fcefyn-testbed/fcefyn_testbed_utils/docs/diseno/rack-diseno-3d.md

---
title: Rack físico
---

# Rack físico

Vista general del **rack en torre** del lab: cajoneras, caja de control, enlace a esquemáticos eléctricos en [arduino-relay](../configuracion/arduino-relay.md) y piezas impresas para conductos y soportes. Fuentes CAD: carpeta **`3d_parts/`** en la raíz del repo (OpenSCAD homónimo del STL cuando aplica).

## Fotos del rack

<div class="rack-gallery" data-rack-gallery tabindex="0">
  <div class="rack-gallery__viewport">
    <figure class="rack-gallery__slide" data-caption="Vista general del rack en torre: cajoneras, cableado y equipos por cajón.">
      Rack en torre con cajoneras plásticas y cableado
    </figure>
    <figure class="rack-gallery__slide" data-caption="Montaje inicial en mesa: routers, hub USB, relés y cableado antes de integrar al rack.">
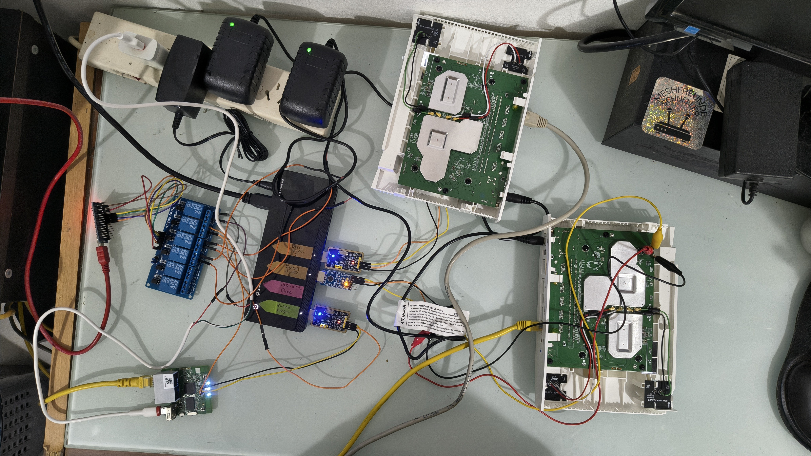
[picture p1: docs/img/rack/starting_point.jpg]
Banco de pruebas en mesa con routers y relés
      
    </figure>
    <figure class="rack-gallery__slide" data-caption="Interior de un cajón: hub USB, módulo de relés y distribución de cables.">
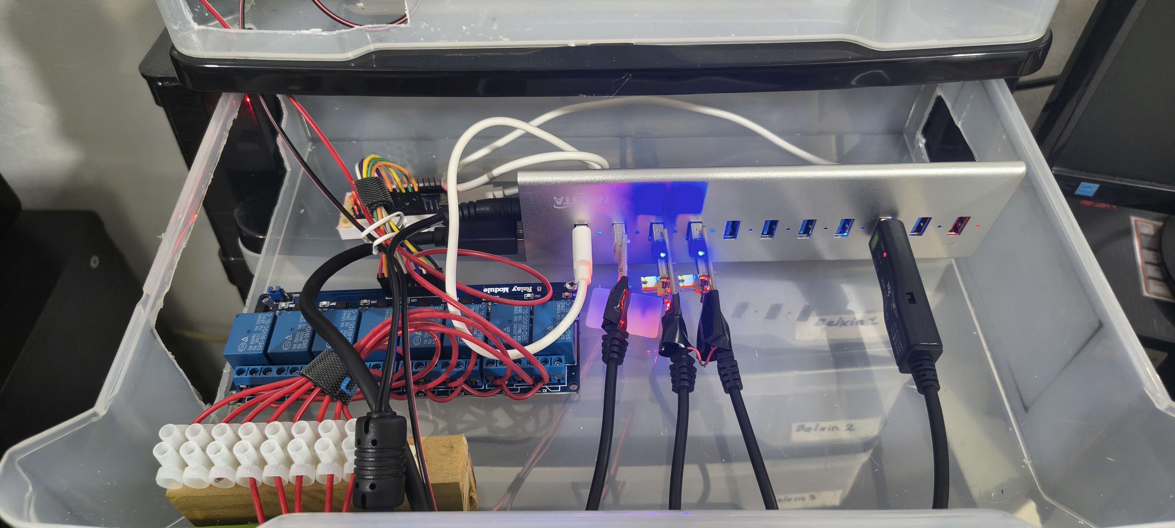
[picture p2: docs/img/rack/rack_2nd_level.jpg]
Cajón del rack con hub USB y relés
      
    </figure>
    <figure class="rack-gallery__slide" data-caption="Cajones superiores abiertos: fuente, hub y cableado entre niveles.">
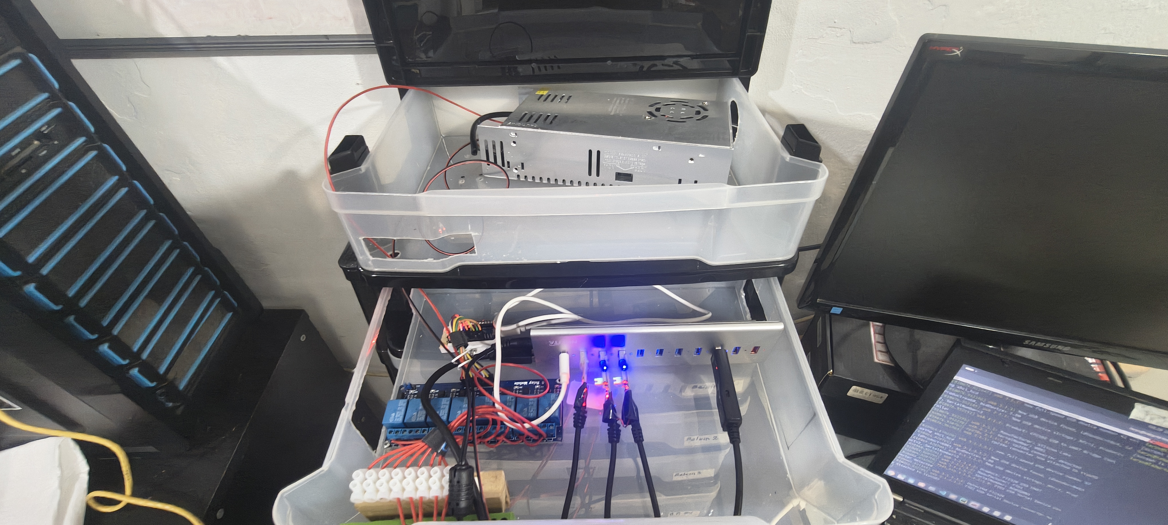
[picture p3: docs/img/rack/rack_1st_2nd_level.jpg]
Dos niveles del rack abiertos con fuente y cableado
      
    </figure>
    <div class="rack-gallery__overlay">
      <span class="rack-gallery__counter" data-rack-counter aria-live="polite"></span>
      <button type="button" class="rack-gallery__btn" data-rack-prev aria-label="Imagen anterior">&#8249;</button>
      <button type="button" class="rack-gallery__btn" data-rack-next aria-label="Imagen siguiente">&#8250;</button>
    </div>
  </div>
  
</div>

## Caja de control (módulo de relés)

Caja aparte del rack: relés/SSR, **UTP** (señal) y **230 V** hacia cooler y fuente. Detalle eléctrico: [arduino-relay](../configuracion/arduino-relay.md).

<div class="rack-gallery" data-rack-gallery tabindex="0">
  <div class="rack-gallery__viewport">
    <figure class="rack-gallery__slide" data-caption="Caja externa del módulo de relés (caja de control).">
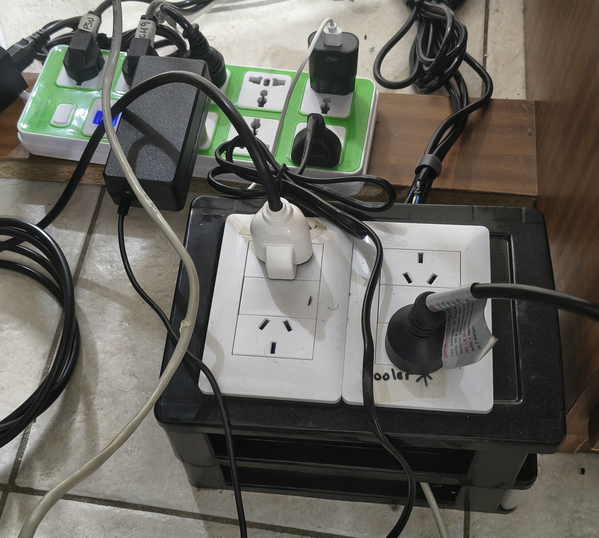
[picture p4: docs/img/rack/reles_box_1.jpg]
Caja de módulo de relés vista exterior
      
    </figure>
    <figure class="rack-gallery__slide" data-caption="Interior: Arduino, relés/SSR y cableado a bornes y UTP.">
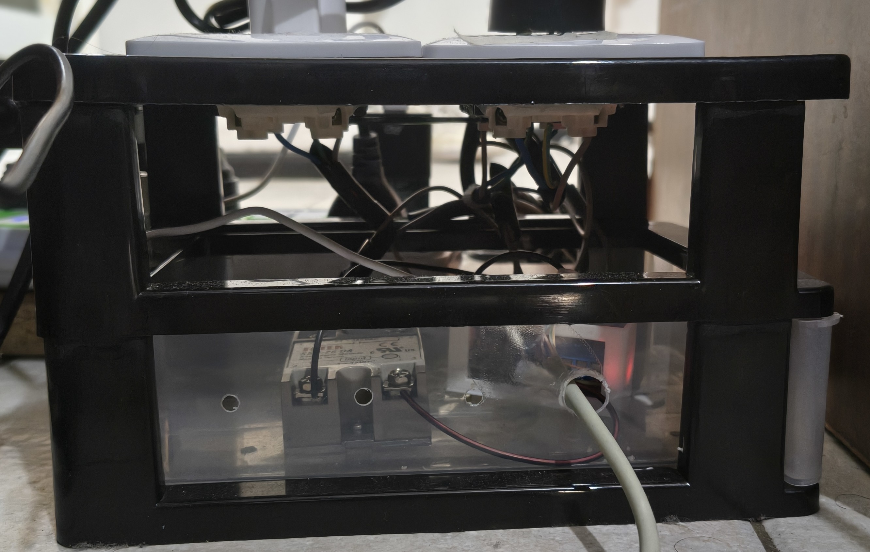
[picture p5: docs/img/rack/reles_box_inside.jpg]
Interior de la caja de relés
      
    </figure>
    <div class="rack-gallery__overlay">
      <span class="rack-gallery__counter" data-rack-counter aria-live="polite"></span>
      <button type="button" class="rack-gallery__btn" data-rack-prev aria-label="Imagen anterior">&#8249;</button>
      <button type="button" class="rack-gallery__btn" data-rack-next aria-label="Imagen siguiente">&#8250;</button>
    </div>
  </div>
  
</div>

## Conexiones y cableado eléctrico {: #conexiones-y-cableado-electrico }

Los esquemáticos de referencia están en [arduino-relay - Esquemas eléctricos](../configuracion/arduino-relay.md#esquemas-electricos-referencia) junto con tablas de pines y comandos serial.

## Consideraciones térmicas y ventilación {: #consideraciones-termicas }

Con el apilado vertical, el aire caliente de los niveles inferiores **asciende** y tiende a estancarse arriba, con riesgo de sobrecalentamiento en los equipos superiores. La mitigación es un **ventilador inferior** (120 mm, 220 V) que empuja aire **frío de abajo hacia arriba** y **conductos impresos** que encaminan el flujo hacia los cajones. Ficha del ventilador: [Catálogo - Bosser 120 mm](../configuracion/catalogo-hardware.md#ventilador-bosser-120-mm-rack).

## Piezas impresas en 3D

Renders y fotos de las piezas usadas en conductos, bases y accesorios. Modelos orientados a imprimir **sin soportes** cuando corresponde (referencia: Creality Ender 3 Pro).

| Cantidad | Archivo STL | Uso |
|---|---|-----|
| 1 | `curved_intake_duct.stl` | Conducto curvo: ventilador 120 mm → chimenea |
| 4 | `airflow_chimney_duct_3levels.stl` | Segmentos verticales con rejillas (3 niveles c/u) |
| 1 | `airflow_chimney_duct_2levels.stl` | Segmento con 2 niveles |
| 1 | `chimney_duct_cover.stl` | Tapa superior de la chimenea |
| 3 | `belkin_rt3200_base.stl` | Base compacta Belkin RT3200 |
| 1 | `CE3PRO_librerouter_rack.stl` | Carcasa abierta LibreRouter (base ventilada, standoffs) |
| 1 | `NanoHolderA.stl` | Soporte Arduino Nano |
| 1 | (aux.) `drawer_stop` | Guía / tope de cajón (asset visual; nombre de archivo según `3d_parts/`) |
| (var.) | `logo fcefyn.stl`, `logo unc.stl` | Logos decorativos |

<div class="rack-gallery rack-gallery--schematics" data-rack-gallery tabindex="0">
  <div class="rack-gallery__viewport">
    <figure class="rack-gallery__slide" data-caption="Conducto de admisión curvado (render OpenSCAD / referencia).">
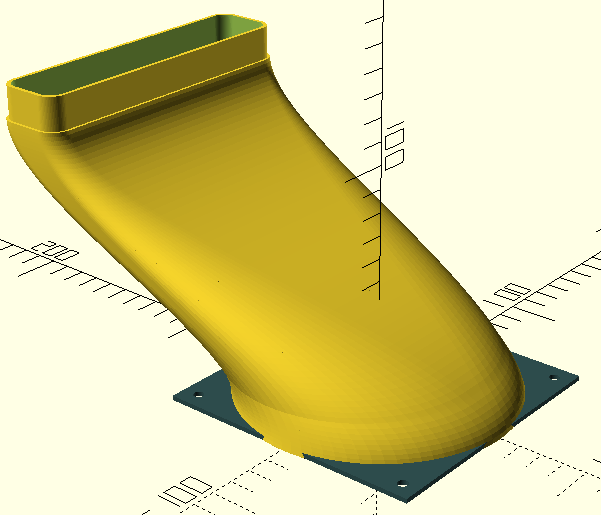
[picture p6: docs/img/rack/curved_intake_duct.png]
Render conducto admisión curvado
      
    </figure>
    <figure class="rack-gallery__slide" data-caption="Módulo chimenea 3 niveles (rejillas orientadas a los routers).">
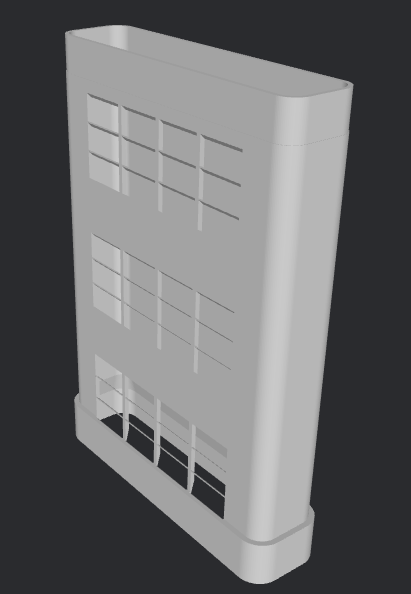
[picture p7: docs/img/rack/airflow_chimney_duct_3levels.png]
Render chimenea tres niveles
      
    </figure>
    <figure class="rack-gallery__slide" data-caption="Módulo chimenea 2 niveles.">
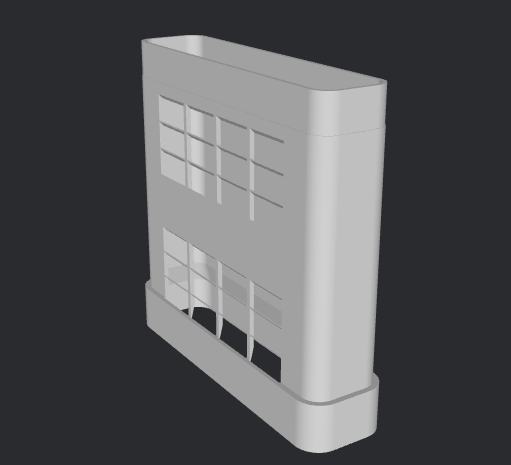
[picture p8: docs/img/rack/airflow_chimney_duct_2levels.png]
Render chimenea dos niveles
      
    </figure>
    <figure class="rack-gallery__slide" data-caption="Tapa superior de chimenea.">
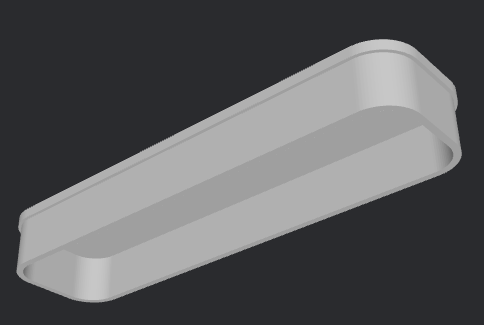
[picture p9: docs/img/rack/chimney_duct_cover.png]
Render tapa chimenea
      
    </figure>
    <figure class="rack-gallery__slide" data-caption="Ventilador 120 mm con conducto curvo montado (foto).">
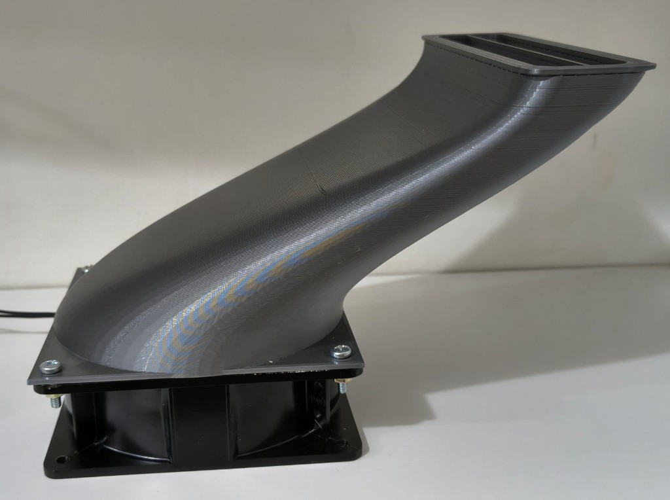
[picture p10: docs/img/rack/cooler_with_duct.jpeg]
Ventilador con conducto curvo montado
      
    </figure>
    <figure class="rack-gallery__slide" data-caption="Base impresa Belkin RT3200 en el rack.">
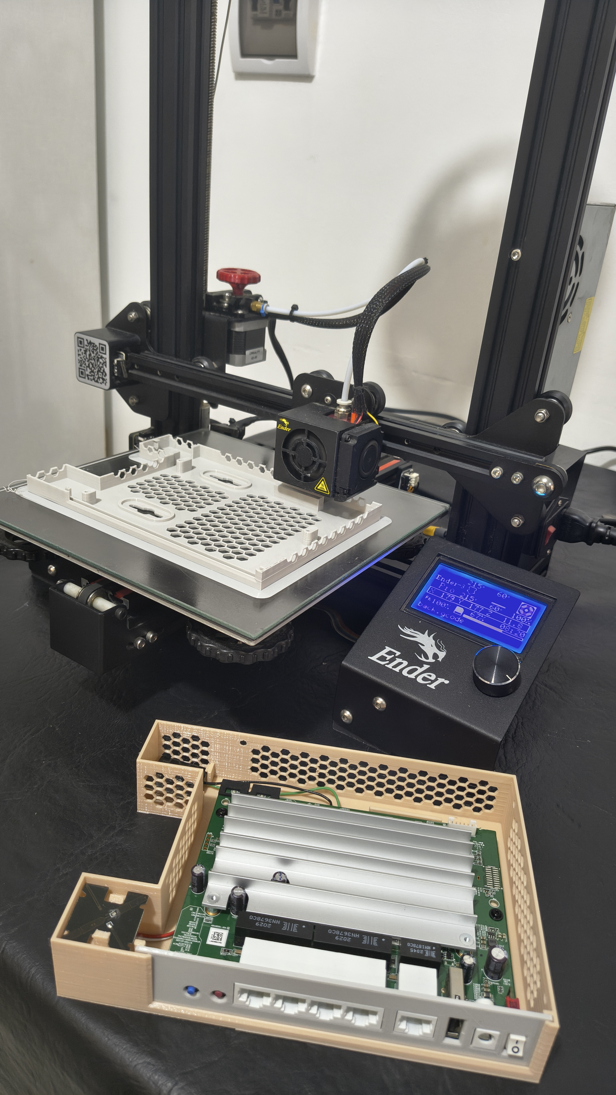
[picture p11: docs/img/rack/belkin_case_adapted.jpg]
Base Belkin adaptada en rack
      
    </figure>
    <figure class="rack-gallery__slide" data-caption="Carcasa abierta LibreRouter.">
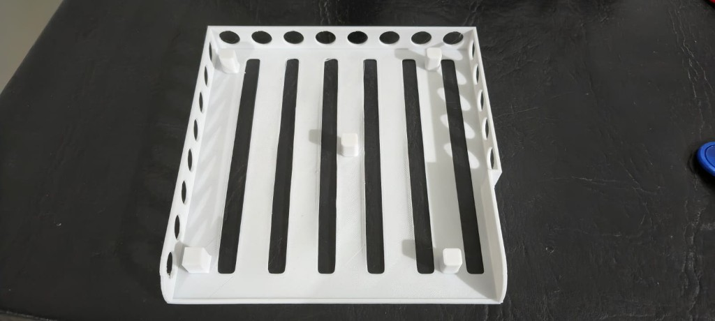
[picture p12: docs/img/rack/librerouter-opencase.jpeg]
Carcasa abierta LibreRouter
      
    </figure>
    <figure class="rack-gallery__slide" data-caption="Soporte Arduino Nano (NanoHolder).">
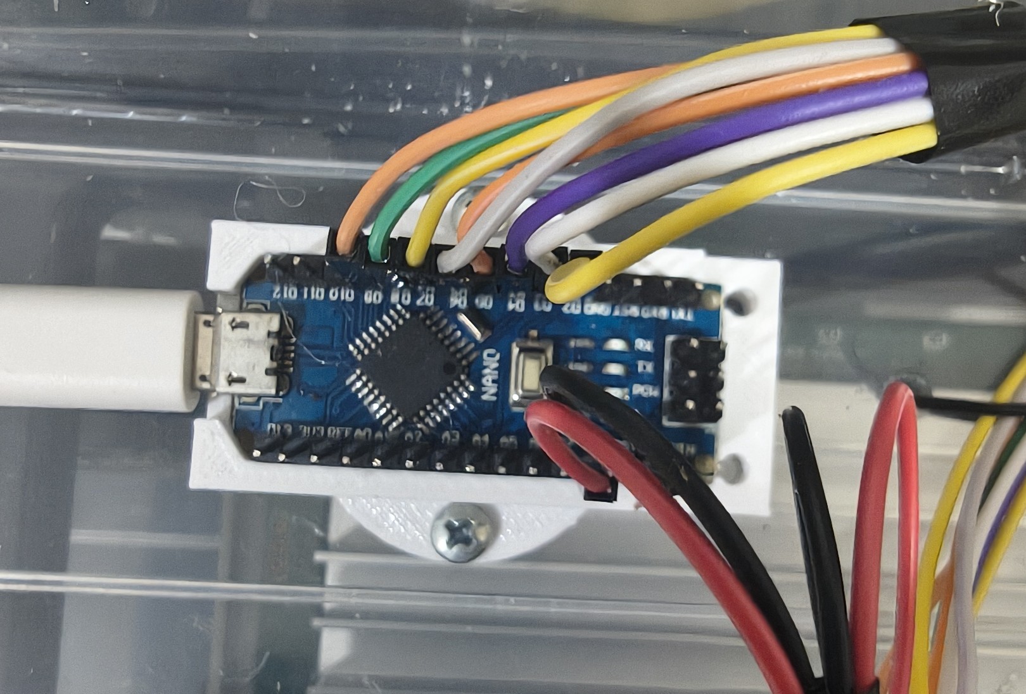
[picture p13: docs/img/rack/NanoHolder.jpg]
Soporte Nano impreso
      
    </figure>
    <figure class="rack-gallery__slide" data-caption="Logos FCEFyN y UNC.">
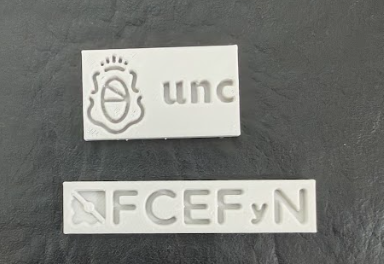
[picture p14: docs/img/rack/logos.png]
Logos FCEFyN y UNC
      
    </figure>
    <div class="rack-gallery__overlay">
      <span class="rack-gallery__counter" data-rack-counter aria-live="polite"></span>
      <button type="button" class="rack-gallery__btn" data-rack-prev aria-label="Imagen anterior">&#8249;</button>
      <button type="button" class="rack-gallery__btn" data-rack-next aria-label="Imagen siguiente">&#8250;</button>
    </div>
  </div>
  
</div>

La base Belkin deriva de [RT3200/E8450 Wall Mount Case](https://www.thingiverse.com/thing:5864938) (TuxInvader): solo la base, parte superior abierta para ventilación.
