fcefyn-testbed/fcefyn_testbed_utils/docs/img/hardware/cooler_bosser.png

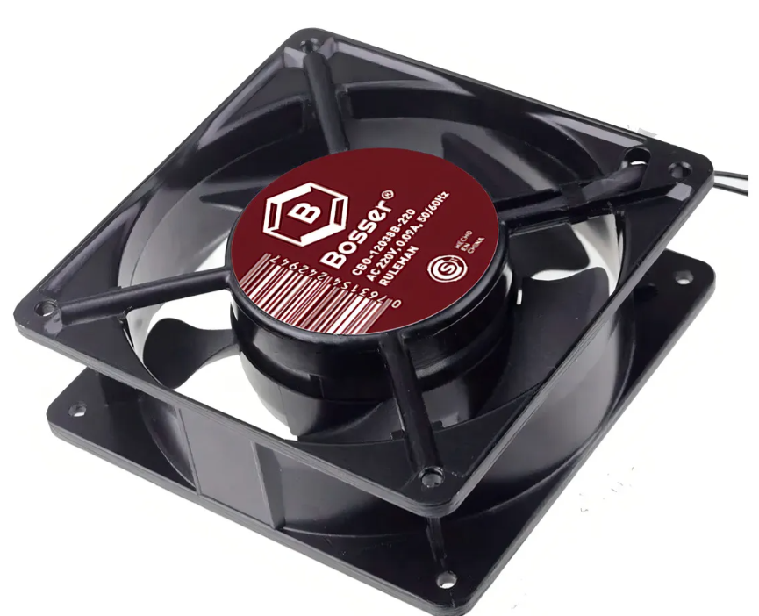
docs/img/hardware/cooler_bosser.png
