fcefyn-testbed/fcefyn_testbed_utils/docs/img/rack/hub_shelf.jpg

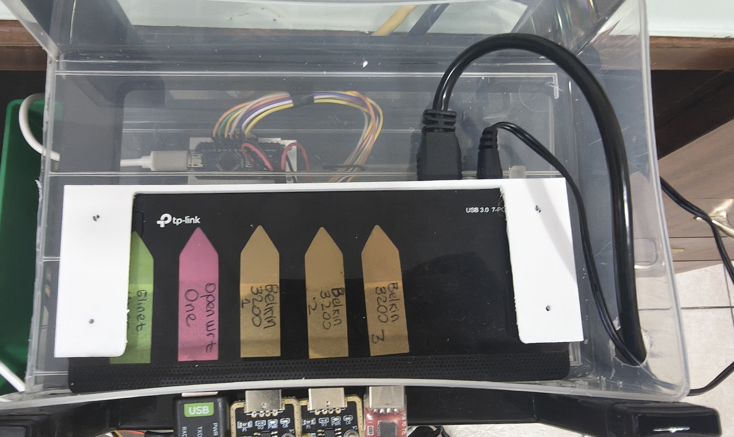
docs/img/rack/hub_shelf.jpg
