fcefyn-testbed/fcefyn_testbed_utils/docs/img/rack/rack.jpg

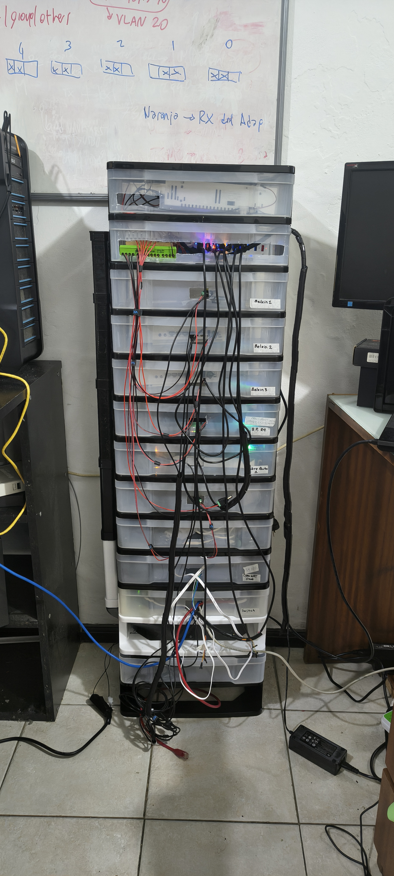
docs/img/rack/rack.jpg
