fcefyn-testbed/fcefyn_testbed_utils/docs/img/rack/schematics/rack-ac-infra.png

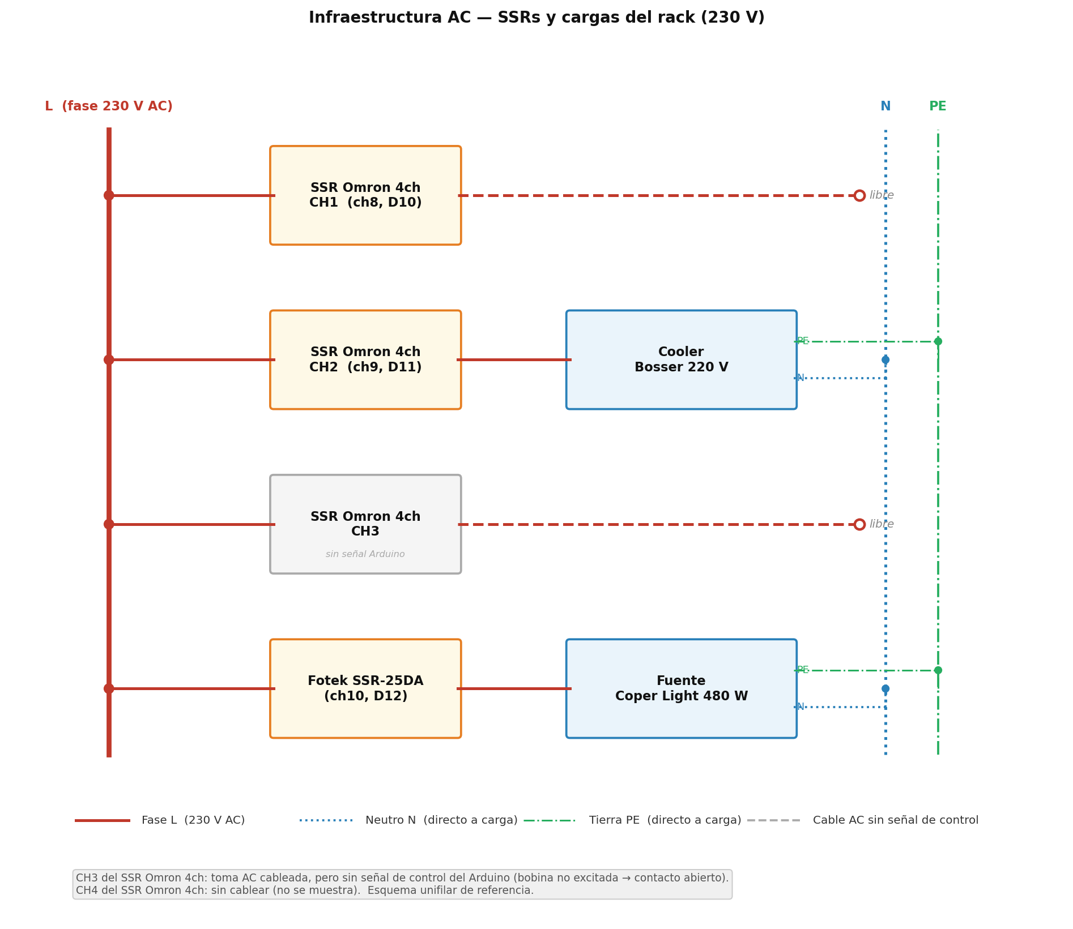
docs/img/rack/schematics/rack-ac-infra.png
