fcefyn-testbed/fcefyn_testbed_utils/docs/img/rack/schematics/rack-dut-relays.png

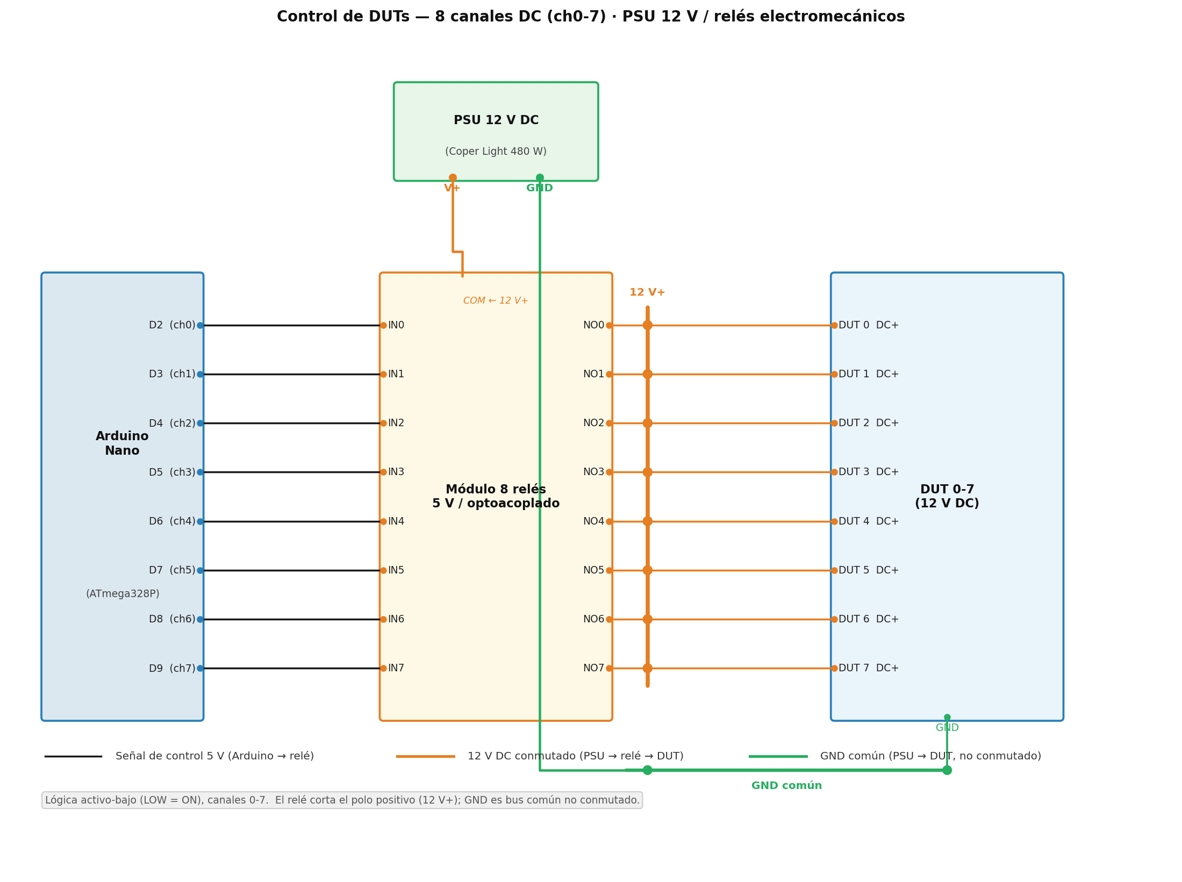
docs/img/rack/schematics/rack-dut-relays.png
