fcefyn-testbed/fcefyn_testbed_utils/docs/img/rack/schematics/rack-signal-utp.png

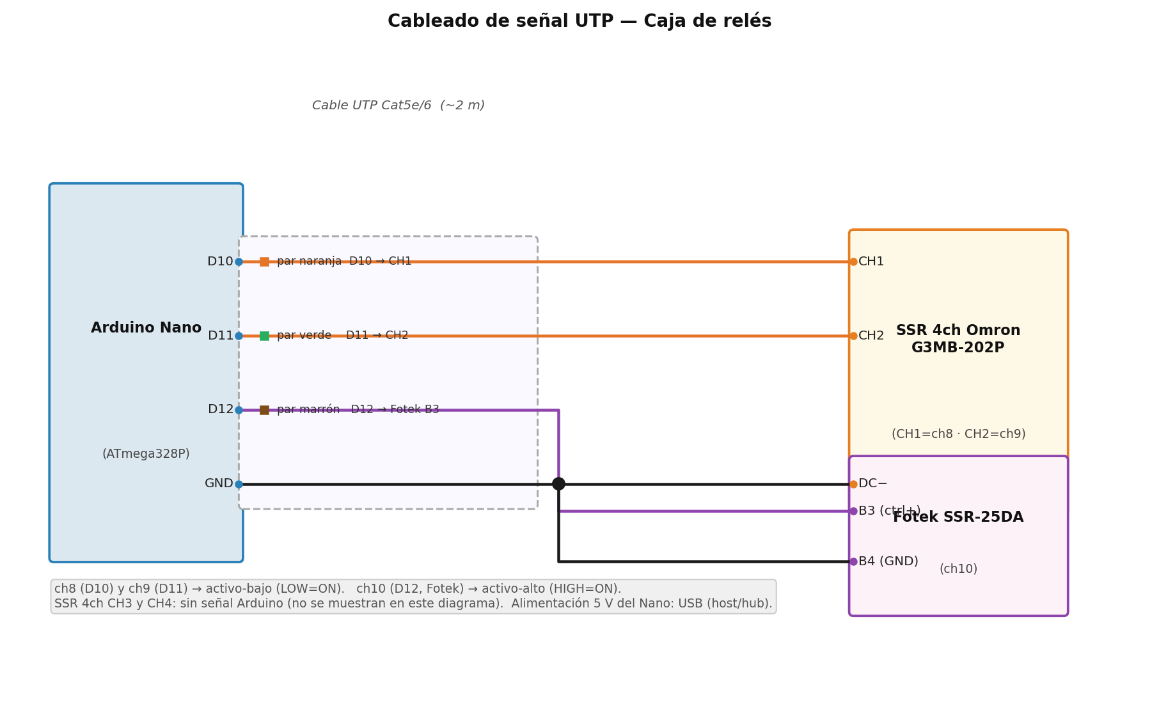
docs/img/rack/schematics/rack-signal-utp.png
