fcefyn-testbed/fcefyn_testbed_utils/(list of files, cad)

Other CAD files:
3d_parts/CE3PRO_librerouter_rack.stl
