fcefyn-testbed/fcefyn_testbed_utils/docs/operar/build-firmware-manual.md

# Manual firmware build (OpenWrt / LibreMesh)

Guide to build images for the lab (`LG_IMAGE`, TFTP).

**Canonical libremesh-tests docs** (suite behaviour, CI image catalog): [LibreMesh testing approach](https://github.com/francoriba/libremesh-tests/blob/main/docs/libremesh-testing-approach.md), [CI firmware catalog](https://github.com/francoriba/libremesh-tests/blob/main/docs/ci-firmware-catalog.md).

---

## Build config per DUT

| DUT | Arch | Subtarget | Profile |
|-----|---|---|---|
| Belkin RT3200 | Mediatek (ARM) | mt7622 | linksys_e8450-ubi |
| Banana Pi R4 | Mediatek (ARM) | filogic | bananapi_bpi-r4 |
| OpenWRT One | Mediatek (ARM) | filogic | openwrt_one |
| LibreRouter 1 | ath79 (MIPS 24Kc) | generic | librerouter_librerouter-v1 |
| Gateway TL-WDR3500 | ath79 (MIPS 74Kc) | generic | tplink_tl-wdr3500-v1 |
| **QEMU x86-64** | x86 | x86_64 | generic |
| **QEMU Malta BE** | malta | be | generic |
| **QEMU armsr-armv8** | armsr | armv8 | generic |

**Usage:** `make menuconfig` → Target System → (Arch) → Subtarget → (Subtarget) → Target Profile → (Profile).

### LibreMesh (lime-packages)

**1. Clone OpenWrt and enter build root**

```bash
git clone -b v23.05.5 --single-branch https://git.openwrt.org/openwrt/openwrt.git
cd openwrt
```

**2. Feeds - OpenWrt default + LibreMesh**

```bash
cp feeds.conf.default feeds.conf
cat << 'EOF' >> feeds.conf

src-git libremesh https://github.com/libremesh/lime-packages.git;v2024.1
src-git profiles https://github.com/libremesh/network-profiles.git
EOF
```

`v2024.1` = LibreMesh 2024.1 (compatible with OpenWrt 23.05.5). Without suffix, `master` is used, which needs OpenWrt 24.10.

**3. Update and install packages**

```bash
scripts/feeds update -a
scripts/feeds install -a
```

**4. `make menuconfig` - Deselect**

| Location | Action |
|---|---|
| Image configuration → Separate feed repositories → Enable feed **libremesh** | Deselect |
| Image configuration → Separate feed repositories → Enable feed **profiles** | Deselect |
| Base system → **dnsmasq** | Deselect |
| Network → **odhcpd-ipv6only** | Deselect |

**5. `make menuconfig` - Select LibreMesh**

| Location |
|----------|
| LibreMesh → **babeld-auto-gw-mode** |
| LibreMesh → Offline Documentation → **lime-docs-minimal** |
| LibreMesh → **lime-app** |
| LibreMesh → **lime-hwd-openwrt-wan** |
| LibreMesh → **lime-proto-anygw** |
| LibreMesh → **lime-proto-babeld** |
| LibreMesh → **lime-proto-batadv** |
| LibreMesh → **shared-state** → shared-state-babeld_hosts |
| LibreMesh → **shared-state** → shared-state-bat_hosts |
| LibreMesh → **shared-state** → shared-state-nodes_and_links |

**5.1 Virtual targets with vwifi (optional)**

Only for mesh tests in QEMU (x86-64, Malta, armsr-armv8) using virtual WiFi:

| Step | Action |
|---|---|
| Feeds | Add to `feeds.conf`: `src-git vwifi https://github.com/javierbrk/vwifi_cli_package` |
| Update | `scripts/feeds update vwifi && scripts/feeds install -a` |
| Menuconfig | Network → **vwifi** |
| wpad | Include **wpad-basic-mbedtls** in the image (without it batman does not see interfaces on vwifi) |

**6. Build**

```bash
make -j$(nproc)
```

Binaries under `bin/targets/.../.../`.  
Source: [libremesh.org/development](https://libremesh.org/development.html)
