fcefyn-testbed/fcefyn_testbed_utils/scripts/switch_state.py

#!/usr/bin/env python3
"""
Switch state tracking - Persist last applied VLAN configuration for differential updates.

Written by pool-manager.py (hybrid mode) and switch_vlan_preset.py (isolated/mesh presets).
Used by pool-manager to avoid redundant switch commands when re-applying the same hybrid config.

State file: ~/.config/labgrid-switch-state.yaml
"""

import logging
import os
from pathlib import Path

try:
    import yaml
except ImportError:
    yaml = None

logger = logging.getLogger(__name__)

STATE_FILE = Path(os.path.expanduser("~/.config/labgrid-switch-state.yaml"))


def load_switch_state() -> dict | None:
    """
    Load switch state from file. Returns None if file does not exist or is invalid.
    """
    if not STATE_FILE.is_file():
        return None
    if yaml is None:
        logger.warning("PyYAML not installed, cannot load switch state")
        return None
    try:
        with open(STATE_FILE) as f:
            data = yaml.safe_load(f)
        if not isinstance(data, dict):
            return None
        return data
    except (OSError, yaml.YAMLError) as e:
        logger.warning("Could not load switch state from %s: %s", STATE_FILE, e)
        return None


def save_switch_state(state: dict) -> None:
    """Write switch state to file."""
    if yaml is None:
        logger.warning("PyYAML not installed, cannot save switch state")
        return
    try:
        STATE_FILE.parent.mkdir(parents=True, exist_ok=True)
        with open(STATE_FILE, "w") as f:
            yaml.dump(state, f, default_flow_style=False, sort_keys=False)
    except OSError as e:
        logger.warning("Could not write switch state to %s: %s", STATE_FILE, e)


def save_preset_state(preset: str) -> None:
    """
    Invalidate hybrid state after applying a full preset (isolated or mesh).
    Call from switch_vlan_preset.py on success.
    """
    save_switch_state({
        "last_applied_by": "switch_vlan_preset",
        "preset": preset,
        "hybrid_ports": None,
        "uplink_tagged_vlans": None,
    })


def save_hybrid_state(ports: dict, uplink_tagged_vlans: list) -> None:
    """
    Save hybrid port state after pool-manager successfully applied config.
    ports: dict mapping port str (e.g. "11") to {"pool": "libremesh"|"openwrt", "vlan": int}
    uplink_tagged_vlans: sorted list of VLAN IDs on uplink ports
    """
    save_switch_state({
        "last_applied_by": "pool-manager",
        "preset": None,
        "hybrid_ports": ports,
        "uplink_tagged_vlans": uplink_tagged_vlans,
    })


def is_hybrid_state_valid_for_diff(state: dict | None) -> bool:
    """Return True if state can be used for differential apply (only changed ports)."""
    if state is None:
        return False
    if state.get("last_applied_by") != "pool-manager":
        return False
    hybrid_ports = state.get("hybrid_ports")
    if not isinstance(hybrid_ports, dict):
        return False
    return True
