fcefyn-testbed/fcefyn_testbed_utils/(commit log)

2025-12-20 refactor: switch to 8 channel relay module
2026-02-23 fix script - power cycle working
    [poe_switch_control.py]
2026-02-23 add template for switch credentials usage from host
2026-03-05 chore: track firmware artifacts with git lfs
2026-03-08 add support for smart switch port configuration when changing testbed modes
2026-03-08 make last testbed mode persistent after host reboots
    [pool-manager.py, switch_vlan_preset.py]
2026-03-08 turn off unnecessary exporters when switching modes
2026-03-09 refactor: make switch logic use different switch drivers if needed
2026-03-13 fix: switch port 1 (openwrt one) disabled PoE after switching from libremesh to openwrt mode
2026-03-17 refactor: update arduino script to support more channels
2026-03-17 feat: add support for switching states from cli tool
2026-03-22 docs: update rack documentation
    [CE3PRO_librerouter_rack.stl]
2026-03-24 feat: improve ip/vlan resolved by ssh alias in hybrid mode
    [pool-manager.py]
2026-03-24 ops:ansible:observability: support multiple devices
2026-03-26 docs: update pages, add schematics, improve images with carrousels
2026-03-30 feat(ansible): add wireguard role for openwrt-tests coordinator tunnel
2026-03-31 docs: switch documentation from esp to english
